dj1yfk/so2rminiplus/README.txt

SO2R MiniPlus - A simple and low cost SO2R controller

by Fabian Kurz, DJ5CW <fabian@fkurz.net>

Homepage:   https://fkurz.net/ham/so2rminiplus/
Repository: https://git.fkurz.net/dj1yfk/so2rminiplus
