dj1yfk/so2rminiplus/so2rminiplus.kicad_pcb

## KiCad design so2rminiplus.kicad_pcb (2025-12-28)

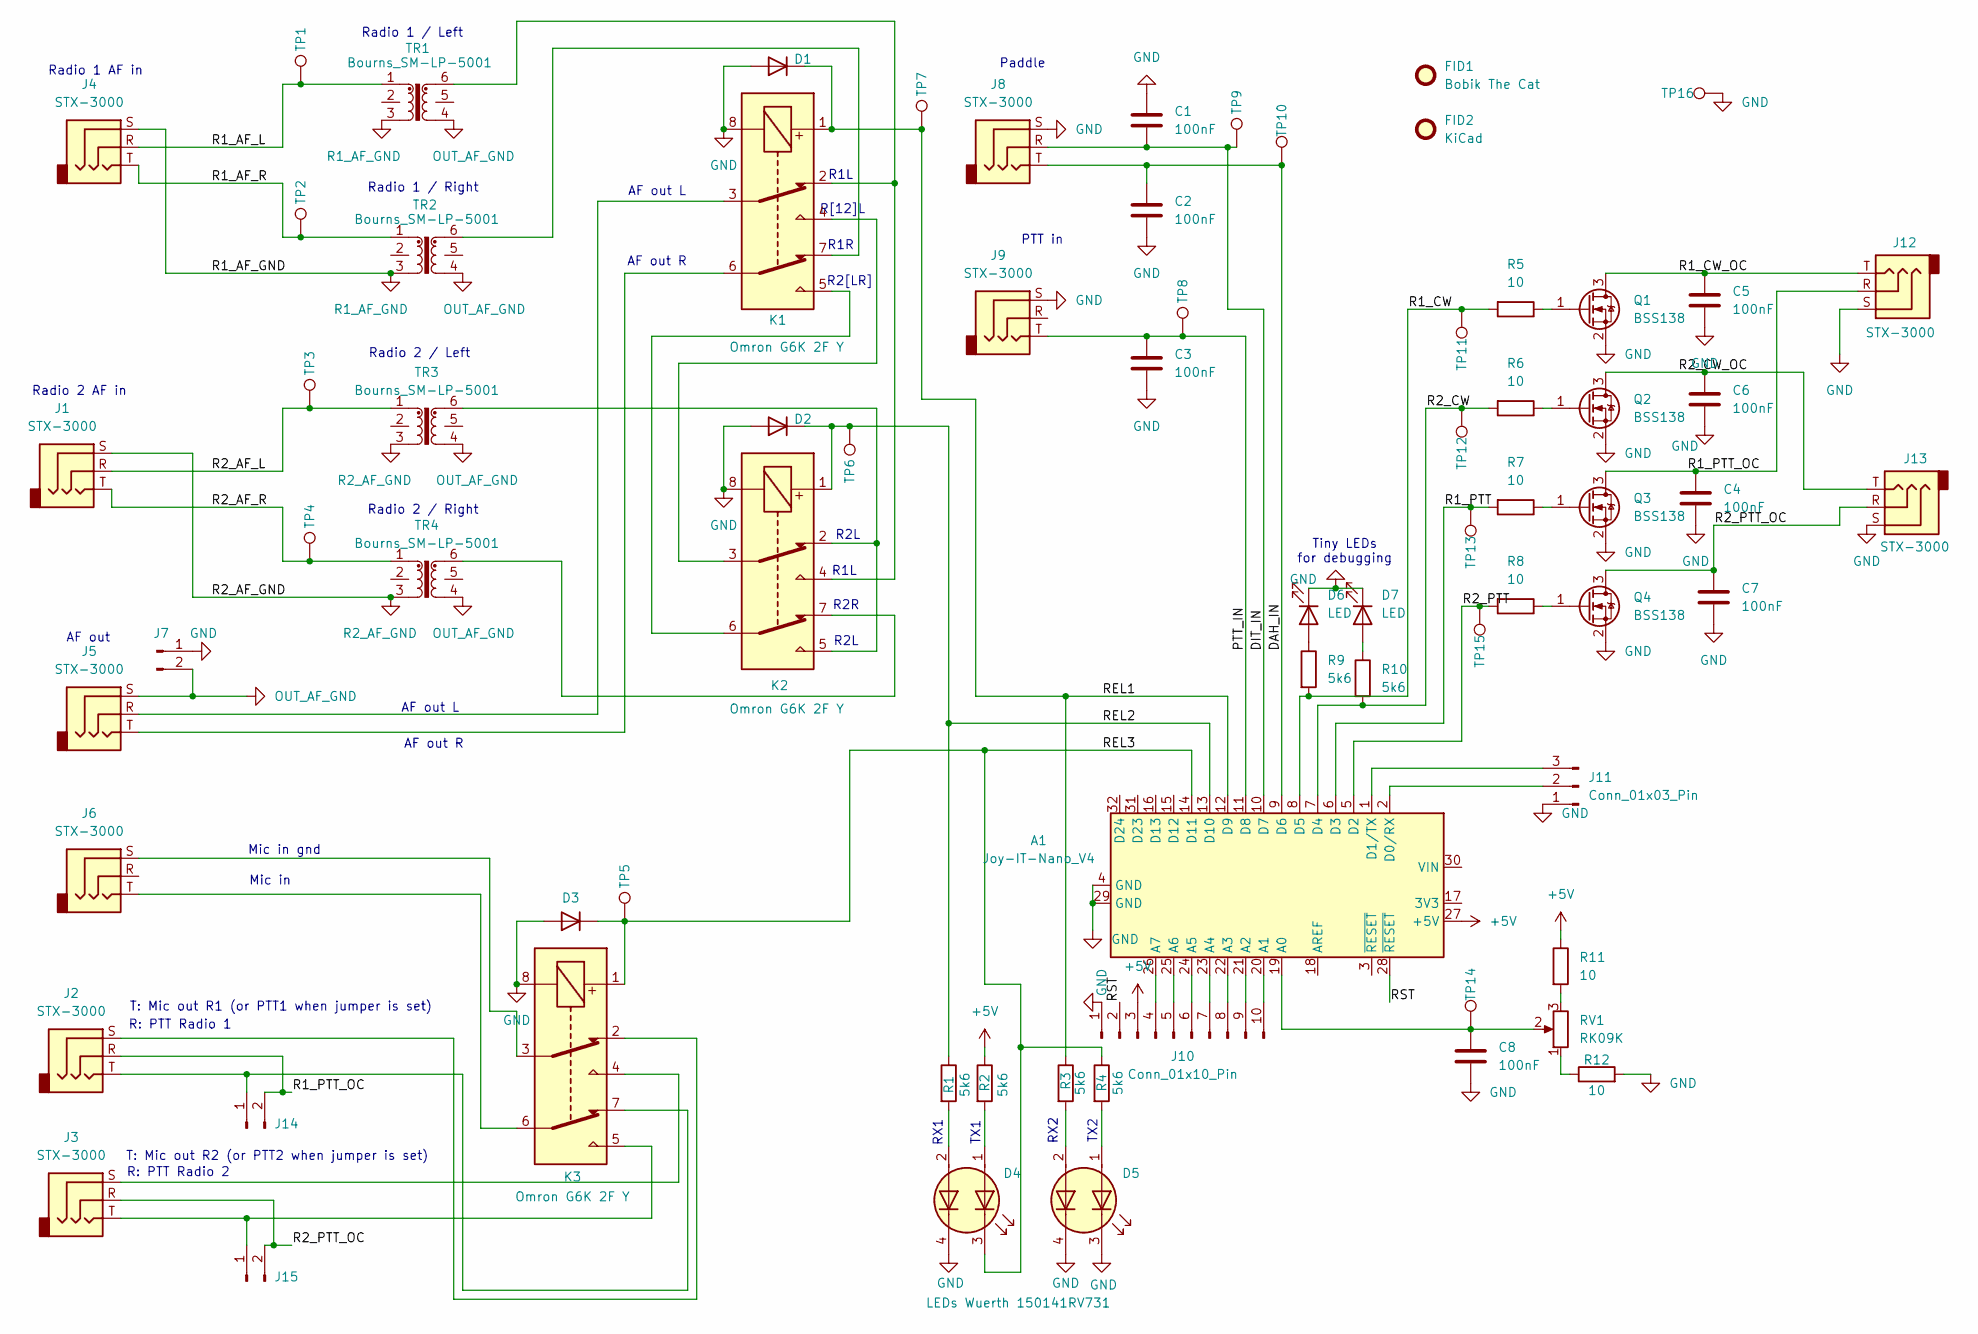
[picture p1: schematic so2rminiplus.kicad_sch, SO2R MiniPlus]

Parts:
A1: Joy-IT-Nano_V4; JoyIT-Nano-V4
C1, C2, C3, C4, C5, C6, C7, C8: 100nF; C_0603_1608Metric_Pad1.08x0.95mm_HandSolder
D1, D2, D3: D; D_SOD-123
D4: LEDs Wuerth 150141RV731; LED_RGB_Wuerth-PLCC4_3.2x2.8mm_150141M173100
D5: LED_Dual_AAKK; LED_RGB_Wuerth-PLCC4_3.2x2.8mm_150141M173100
D6, D7: LED; LED_0402_1005Metric_Pad0.77x0.64mm_HandSolder
FID1: Bobik The Cat; bobik
FID2: KiCad; KiCad-Logo2_5mm_SilkScreen
J1, J2, J3, J4, J5, J6, J8, J9, J12, J13: STX-3000; Jack_3.5mm_Kycon_STX-3000_Horizontal
J7, J14, J15: Conn_01x02_Pin; PinHeader_1x02_P2.54mm_Vertical
J10: Conn_01x10_Pin; PinHeader_1x10_P2.54mm_Vertical
J11: Conn_01x03_Pin; PinHeader_1x03_P2.54mm_Vertical
K1, K2, K3: Omron G6K 2F Y; Relay_DPDT_Omron_G6K-2F-Y
Q1, Q2, Q3, Q4: BSS138; SOT-23
R1, R2, R3, R4: 5k6; R_0603_1608Metric_Pad0.98x0.95mm_HandSolder
R5, R6, R7, R8, R11, R12: 10; R_0603_1608Metric_Pad0.98x0.95mm_HandSolder
R9, R10: 5k6; R_0402_1005Metric_Pad0.72x0.64mm_HandSolder
RV1: RK09K; Potentiometer_Alps_RK09K_Single_Horizontal
TP1, TP2, TP3, TP4, TP5, TP6, TP7, TP8, TP9, TP10, TP11, TP12, TP13, TP14, TP15, TP16: TestPoint; TestPoint_THTPad_1.0x1.0mm_Drill0.5mm
TR1, TR2, TR3, TR4: Bourns_SM-LP-5001; Transformer_Bourns_SM-LP-5001

Connections:
+5V: A1.27 (+5V), J10.3, R2.1, R11.1
/DAH_IN: A1.9 (D6), C2.1, J8.T, TP10.1
/DIT_IN: A1.10 (D7), C1.2, J8.R, TP9.1
/PTT_IN: A1.11 (D8), C3.1, J9.T, TP8.1
/R1_AF_L: J4.R, TP1.1, TR1.1
/R1_AF_R: J4.T, TP2.1, TR2.1
/R1_CW: A1.8 (D5), R5.2, R9.2, TP11.1
/R1_CW_OC: C5.1, J12.T, Q1.3 (D)
/R1_PTT: A1.6 (D3), R7.2, TP13.1
/R1_PTT_OC: C4.1, J2.R, J12.R, J14.2, Q3.3 (D)
/R2_AF_L: J1.R, TP3.1, TR3.1
/R2_AF_R: J1.T, TP4.1, TR4.1
/R2_CW: A1.7 (D4), R6.2, R10.2, TP12.1
/R2_CW_OC: C6.1, J13.T, Q2.3 (D)
/R2_PTT: A1.5 (D2), R8.2, TP15.1
/R2_PTT_OC: C7.1, J3.R, J13.R, J15.2, Q4.3 (D)
/REL1: A1.12 (D9), D1.1 (K), K1.1, R3.1, TP7.1
/REL2: A1.13 (D10), D2.1 (K), K2.1, R1.1, TP6.1
/REL3: A1.14 (D11), D3.1 (K), D4.3 (K1), K3.1, R4.1, TP5.1
/RST: A1.28 (~RESET), J10.2
GND: A1.4 (GND), A1.29 (GND), C1.1, C2.2, C3.2, C4.2, C5.2, C6.2, C7.2, C8.2, D1.2 (A), D2.2 (A), D3.2 (A), D4.4 (K2), D5.3 (K1), D5.4 (K2), D6.1 (K), D7.1 (K), J7.1, J8.S, J9.S, J10.1, J11.1, J12.S, J13.S, K1.8, K2.8, K3.8, Q1.2 (S), Q2.2 (S), Q3.2 (S), Q4.2 (S), R12.2, TP16.1
unnamed: A1.19 (A0), C8.1, RV1.2, TP14.1
unnamed: A1.20 (A1), J10.10
unnamed: A1.21 (A2), J10.9
unnamed: A1.22 (A3), J10.8
unnamed: A1.23 (A4), J10.7
unnamed: A1.24 (A5), J10.6
unnamed: A1.25 (A6), J10.5
unnamed: A1.26 (A7), J10.4
unnamed: A1.2 (D0/RX), J11.2
unnamed: A1.1 (D1/TX), J11.3
unnamed: D4.1 (A1), R2.2
unnamed: D4.2 (A2), R1.2
unnamed: D5.1 (A1), R4.2
unnamed: D5.2 (A2), R3.2
unnamed: D6.2 (A), R9.1
unnamed: D7.2 (A), R10.1
unnamed: J2.S, K3.2
unnamed: J3.S, K3.4
unnamed: J5.R, K1.3
unnamed: J5.T, K1.6
unnamed: J6.S, K3.3
unnamed: J6.T, K3.6
unnamed: J2.T, J14.1, K3.7
unnamed: J3.T, J15.1, K3.5
unnamed: K1.2, K2.4, TR1.6
unnamed: K1.4, K2.3
unnamed: K1.5, K2.6
unnamed: K1.7, TR2.6
unnamed: K2.2, K2.5, TR3.6
unnamed: K2.7, TR4.6
unnamed: Q1.1 (G), R5.1
unnamed: Q2.1 (G), R6.1
unnamed: Q3.1 (G), R7.1
unnamed: Q4.1 (G), R8.1
unnamed: R11.2, RV1.3
unnamed: R12.1, RV1.1
OUT_AF_GND: J5.S, J7.2, TR1.4, TR2.4, TR3.4, TR4.4
R1_AF_GND: J4.S, TR1.3, TR2.3
R2_AF_GND: J1.S, TR3.3, TR4.3

Notes on the sheet:
Radio 1 AF in
T: Mic out R1 (or PTT1 when jumper is set)
RX1
R: PTT Radio 2
R2[LR]
Mic in gnd
Radio 1 / Left
TX1
PTT in
R1L
Radio 1 / Right
AF out L
Mic in
Radio 2 AF in
Tiny LEDs for debugging
R1R
RX2
Radio 2 / Right
T: Mic out R2 (or PTT2 when jumper is set)
R2L
Paddle
Radio 2 / Left
R[12]L
R: PTT Radio 1
AF out R
R2R
AF out
TX2

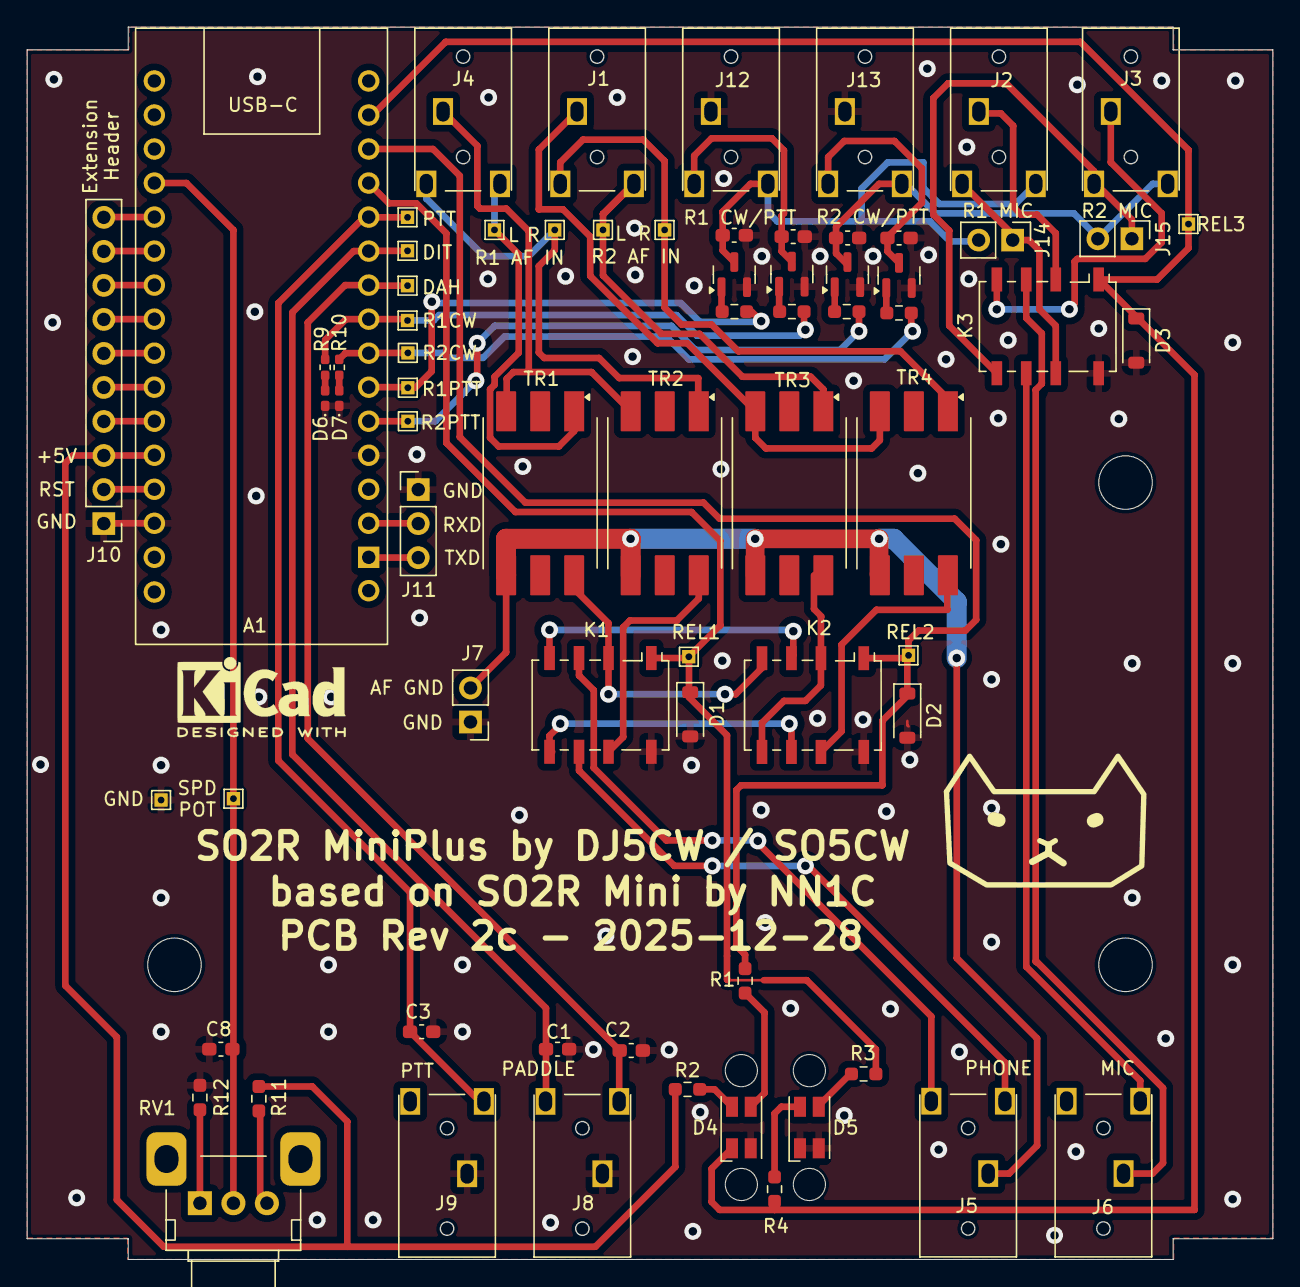
[picture p2: board so2rminiplus.kicad_pcb from above]

Board: 2 copper layers, 93.0 x 92.0 mm, 73 parts (0 on the bottom side), 60 nets.
