dj1yfk/so2rminiplus/(commit log)

2025-08-24 Initial commit so2r mini plus rev2
    [so2rminiplus.kicad_pcb, so2rminiplus.kicad_sch]
2025-09-03 Make assembly layer more readable.
    [so2rminiplus.kicad_pcb]
2025-12-18 Fix: Use correct part number for WUE dual colour LED
    [so2rminiplus.kicad_sch]
2025-12-28 Fix swapped pins 4 and 7 on relay K3.
    Thanks to Peter, LA7WRA / LZ1VPC for finding this!
    [so2rminiplus.kicad_pcb, so2rminiplus.kicad_sch]
2026-05-23 Add front and rear panels
    [so2rminiplus-panel-back.kicad_pcb, so2rminiplus-panel-front.kicad_pcb]
